Kolyhov/hls2915-servo-gimbal/docs/Render_Album_RU.pdf

# Три привода - три движения камеры

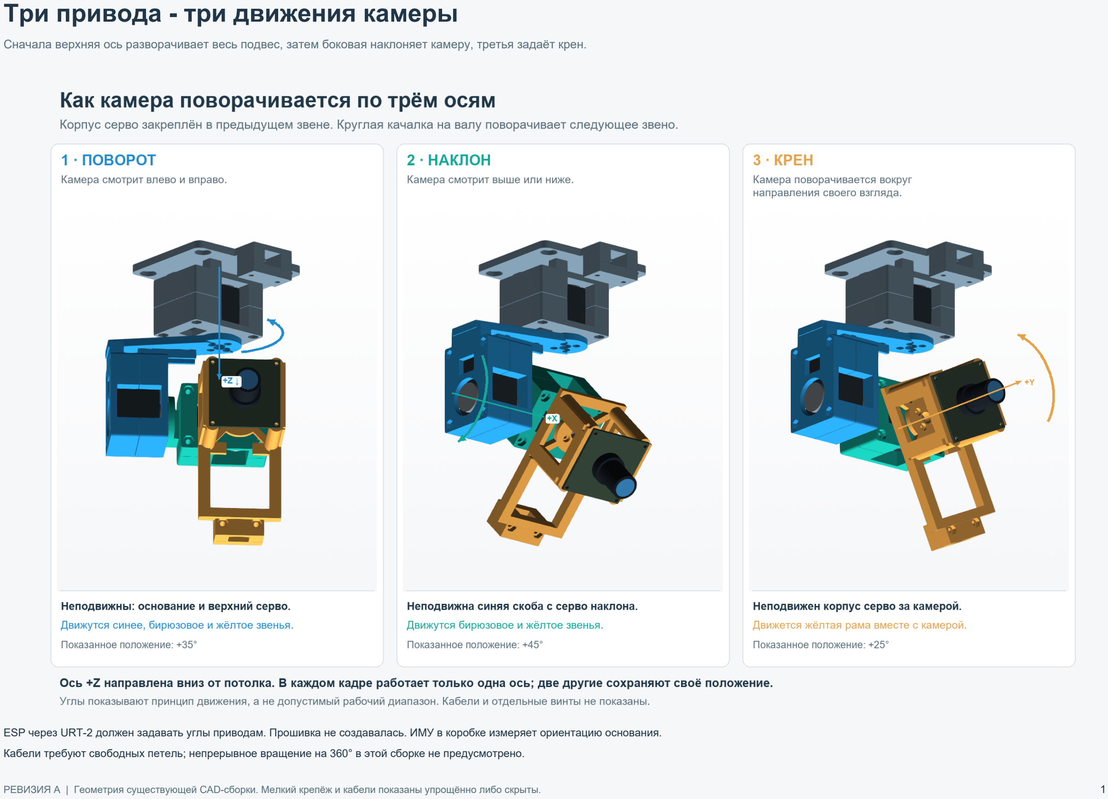
[picture p7: page 1]

Сначала верхняя ось разворачивает весь подвес, затем боковая наклоняет камеру, третья задаёт крен.

РЕВИЗИЯ A | Геометрия существующей CAD-сборки. Мелкий крепёж и кабели показаны упрощённо либо скрыты. | 1

ESP через URT-2 должен задавать углы приводам. Прошивка не создавалась. ИМУ в коробке измеряет ориентацию основания.

Кабели требуют свободных петель; непрерывное вращение на 360° в этой сборке не предусмотрено.

# Вся установка в сборе

Гимбал и коробка крепятся к потолку отдельно. Серый фрагмент - условный потолок.

РЕВИЗИЯ A | Геометрия существующей CAD-сборки. Мелкий крепёж и кабели показаны упрощённо либо скрыты. | 2
Спереди | Сзади
На уровне камеры | Снизу

# Гимбал: основные ракурсы

Синий кронштейн - поворот; зелёный - наклон; жёлтая рамка - крен.

РЕВИЗИЯ A | Геометрия существующей CAD-сборки. Мелкий крепёж и кабели показаны упрощённо либо скрыты. | 3
Спереди справа | Сзади слева
Спереди | Сзади

# Гимбал: боковые виды и наклон

Последний кадр: поворот 30°, наклон вниз 60°, крен 15°. Кабельные петли не показаны.

РЕВИЗИЯ A | Геометрия существующей CAD-сборки. Мелкий крепёж и кабели показаны упрощённо либо скрыты. | 4
Слева | Справа
Снизу | Камера повёрнута и наклонена

# Коробка в сборе: внешние виды

USB и выход шины | Противоположный угол

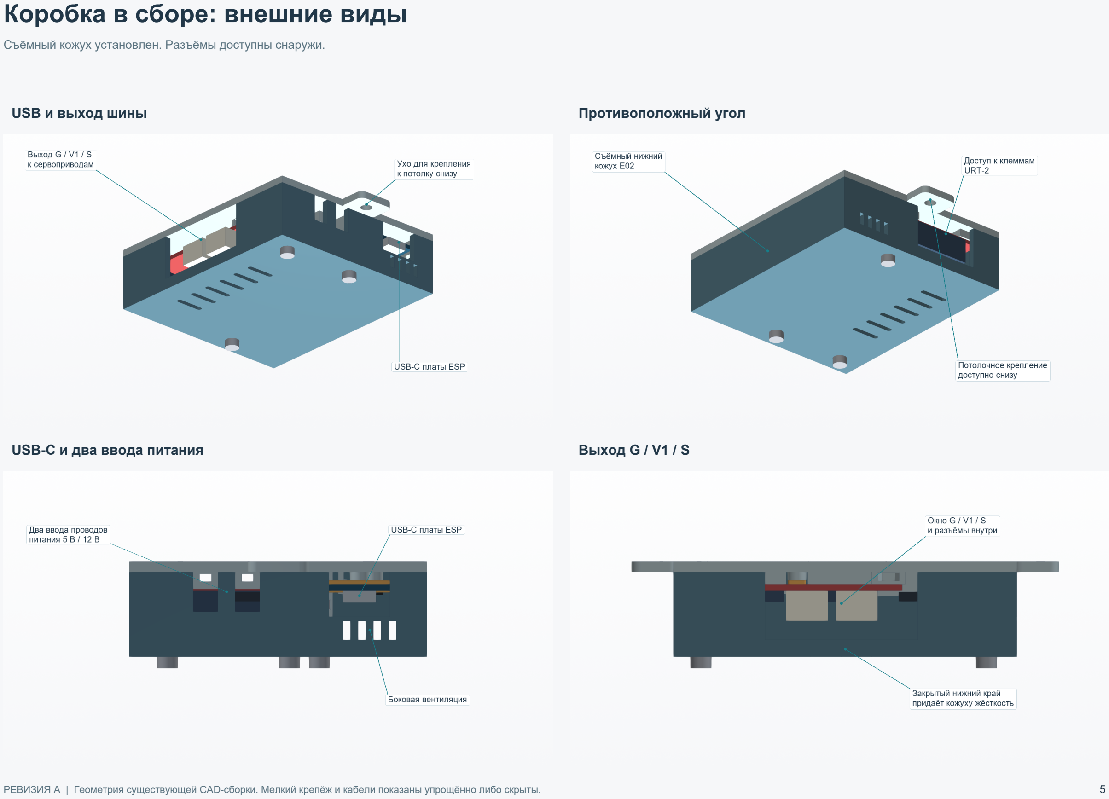
[picture p8: page 5]

Съёмный кожух установлен. Разъёмы доступны снаружи.

РЕВИЗИЯ A | Геометрия существующей CAD-сборки. Мелкий крепёж и кабели показаны упрощённо либо скрыты. | 5
USB-C и два ввода питания | Выход G / V1 / S

# Коробка: крепление, вентиляция и платы

Клеммы URT-2 | Вид снизу: вентиляция и винты

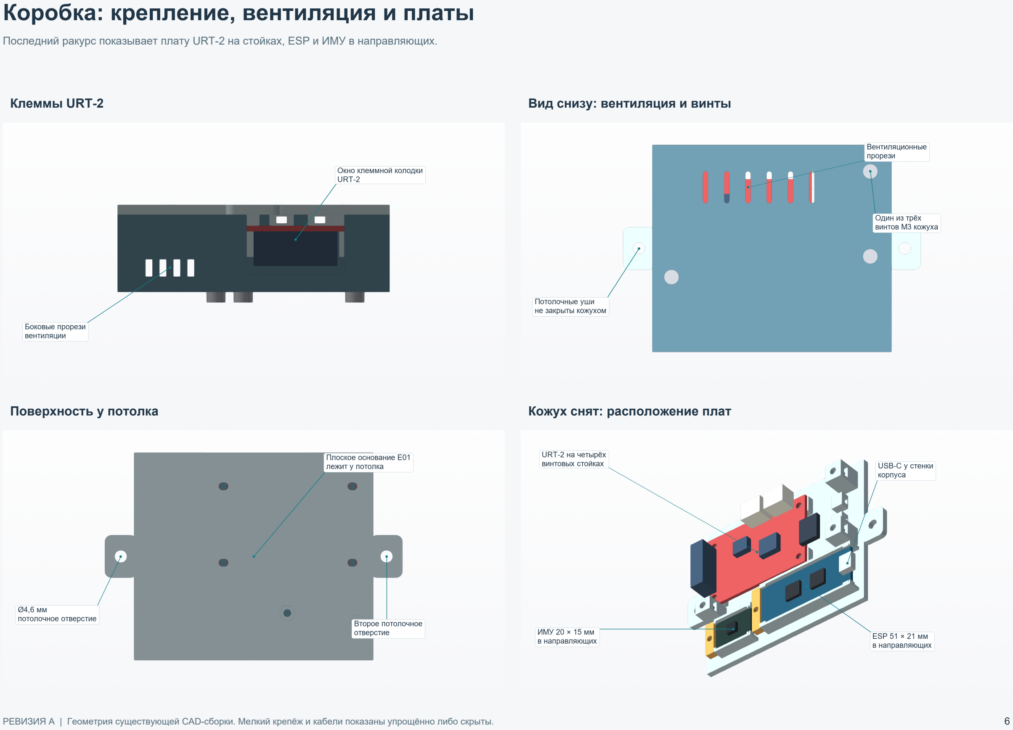
[picture p9: page 6]

Последний ракурс показывает плату URT-2 на стойках, ESP и ИМУ в направляющих.

РЕВИЗИЯ A | Геометрия существующей CAD-сборки. Мелкий крепёж и кабели показаны упрощённо либо скрыты. | 6
Поверхность у потолка | Кожух снят: расположение плат
