Kolyhov/hls2915-servo-gimbal/assets/motion-explained.gif

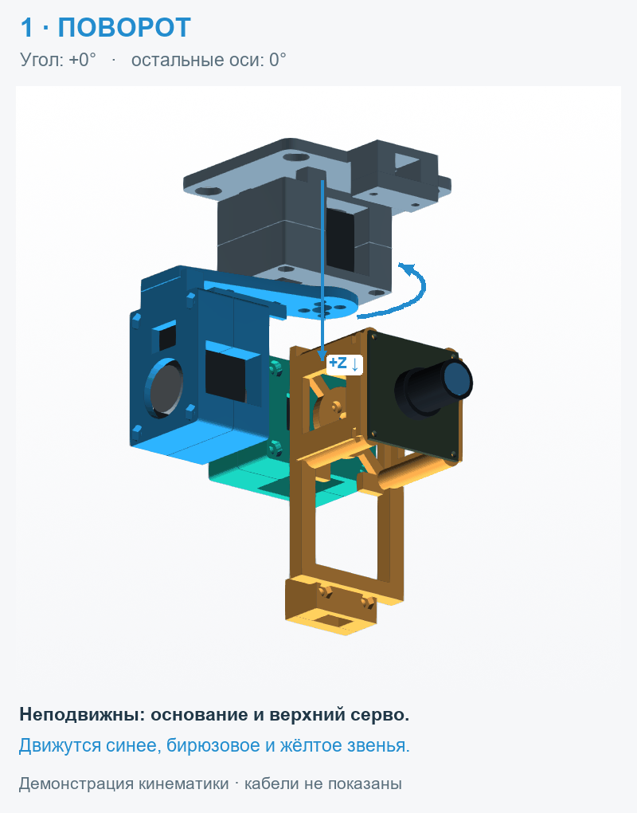
assets/motion-explained.gif
