Kolyhov/hls2915-servo-gimbal/assets/system-views.png

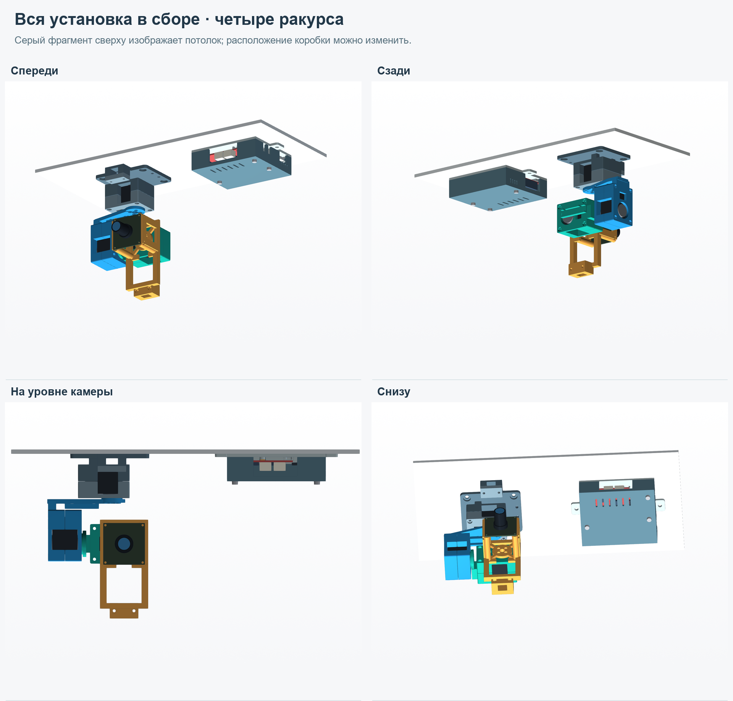
assets/system-views.png
