Kolyhov/hls2915-servo-gimbal/renders/enclosure/01_iso_usb_gvs.png

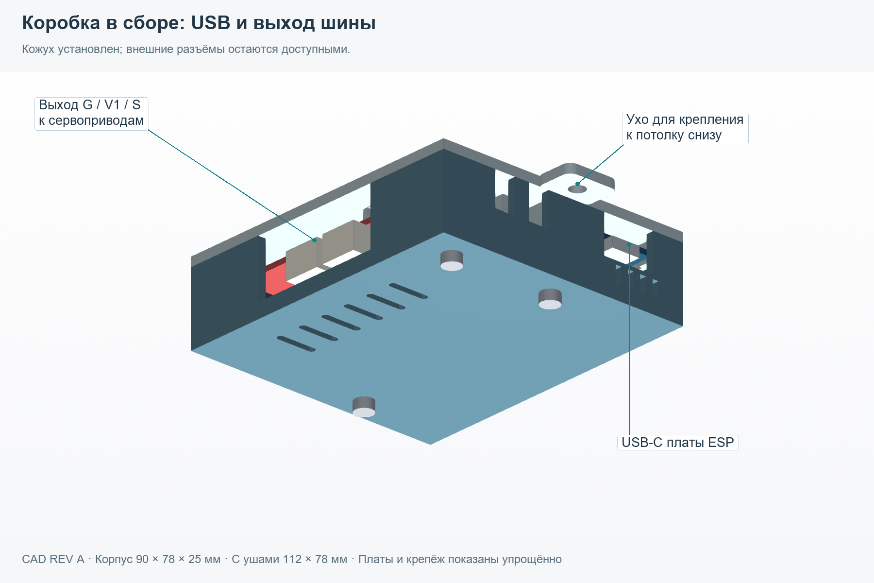
renders/enclosure/01_iso_usb_gvs.png
