Kolyhov/hls2915-servo-gimbal/renders/enclosure/02_iso_terminal_rear.png

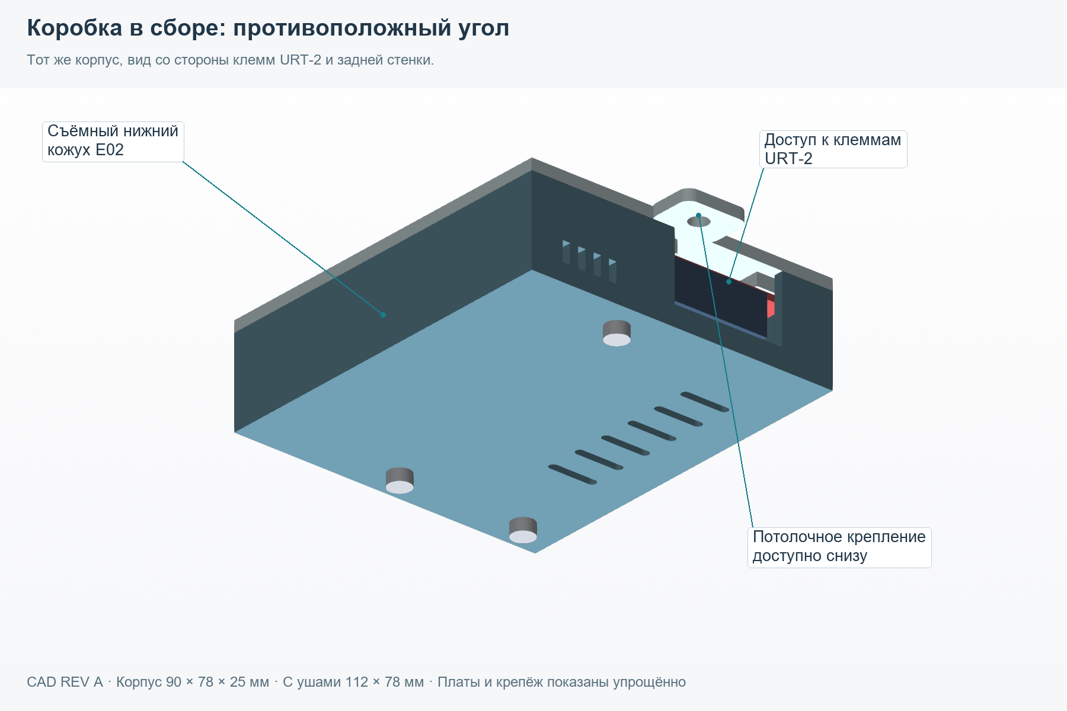
renders/enclosure/02_iso_terminal_rear.png
