Kolyhov/hls2915-servo-gimbal/renders/enclosure/03_usb_power_side.png

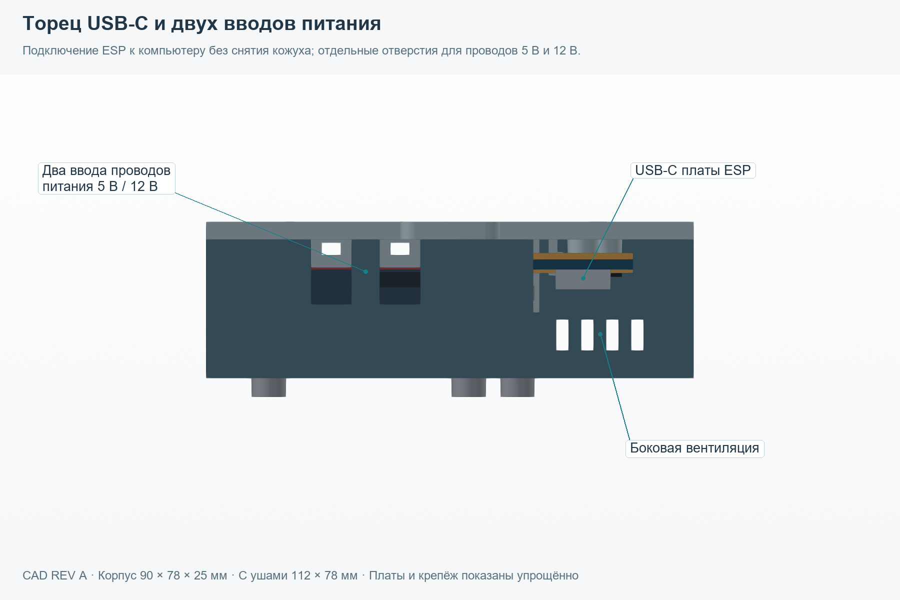
renders/enclosure/03_usb_power_side.png
