Kolyhov/hls2915-servo-gimbal/renders/enclosure/04_servo_bus_side.png

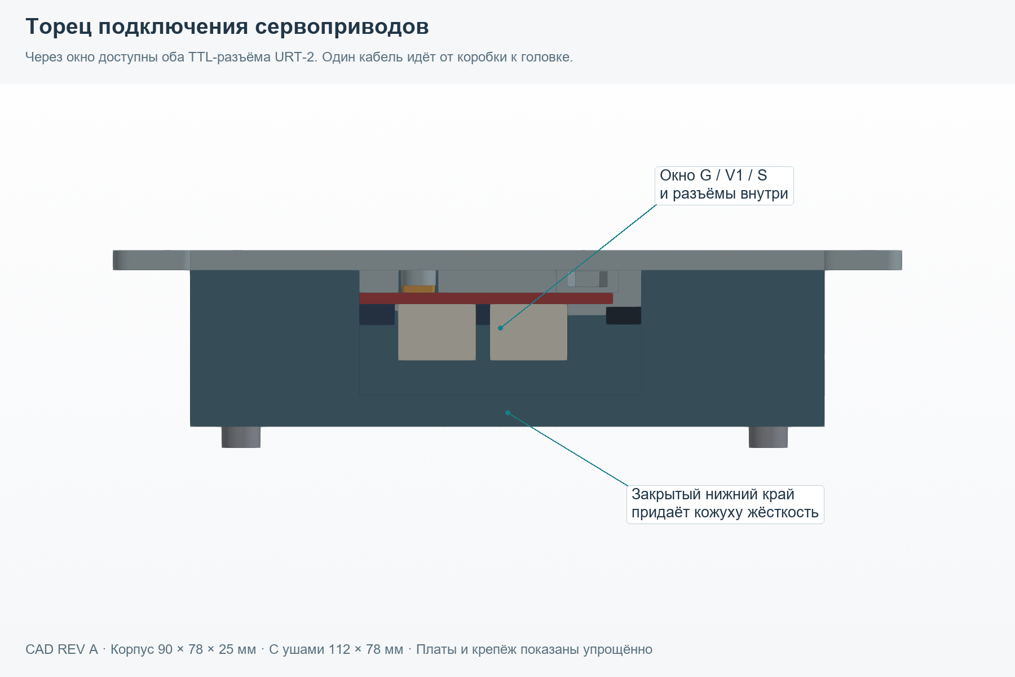
renders/enclosure/04_servo_bus_side.png
