Kolyhov/hls2915-servo-gimbal/renders/enclosure/05_terminal_power_side.png

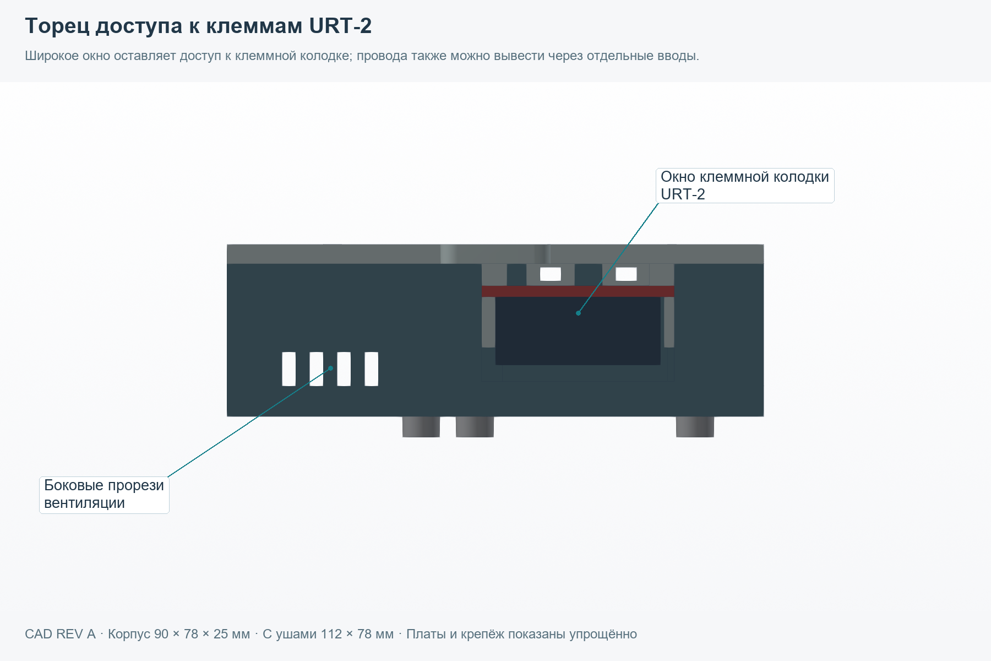
renders/enclosure/05_terminal_power_side.png
