Kolyhov/hls2915-servo-gimbal/renders/enclosure/06_underside_ventilation.png

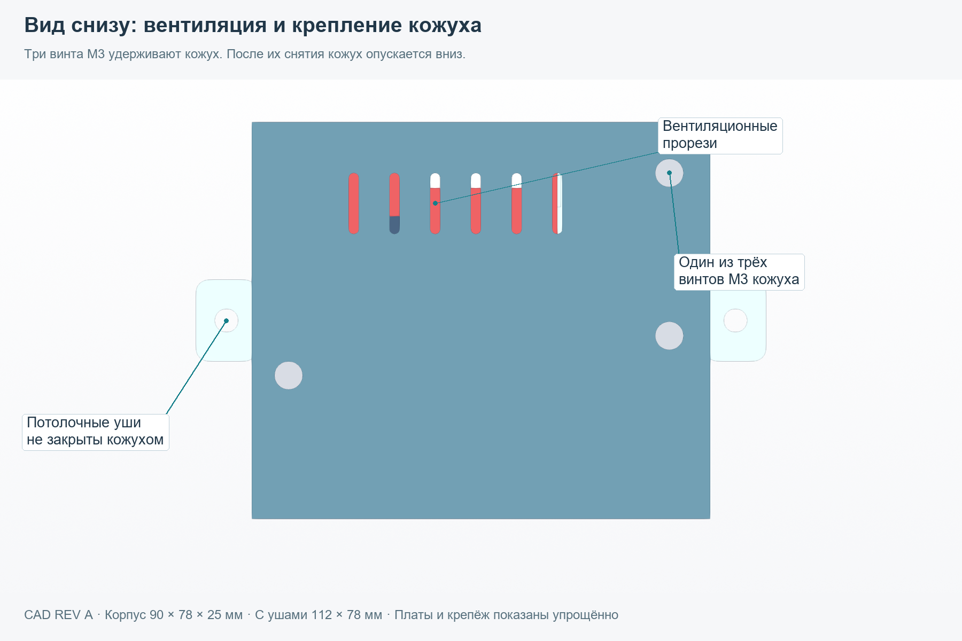
renders/enclosure/06_underside_ventilation.png
