Kolyhov/hls2915-servo-gimbal/renders/enclosure/07_ceiling_attachment_face.png

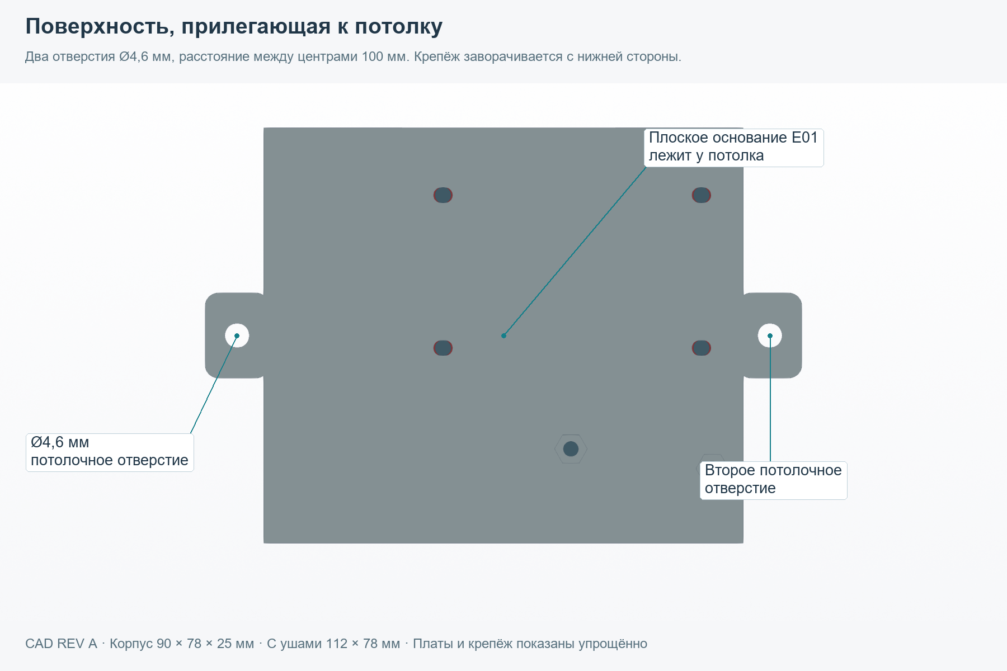
renders/enclosure/07_ceiling_attachment_face.png
