Kolyhov/hls2915-servo-gimbal/renders/enclosure/08_open_electronics_context.png

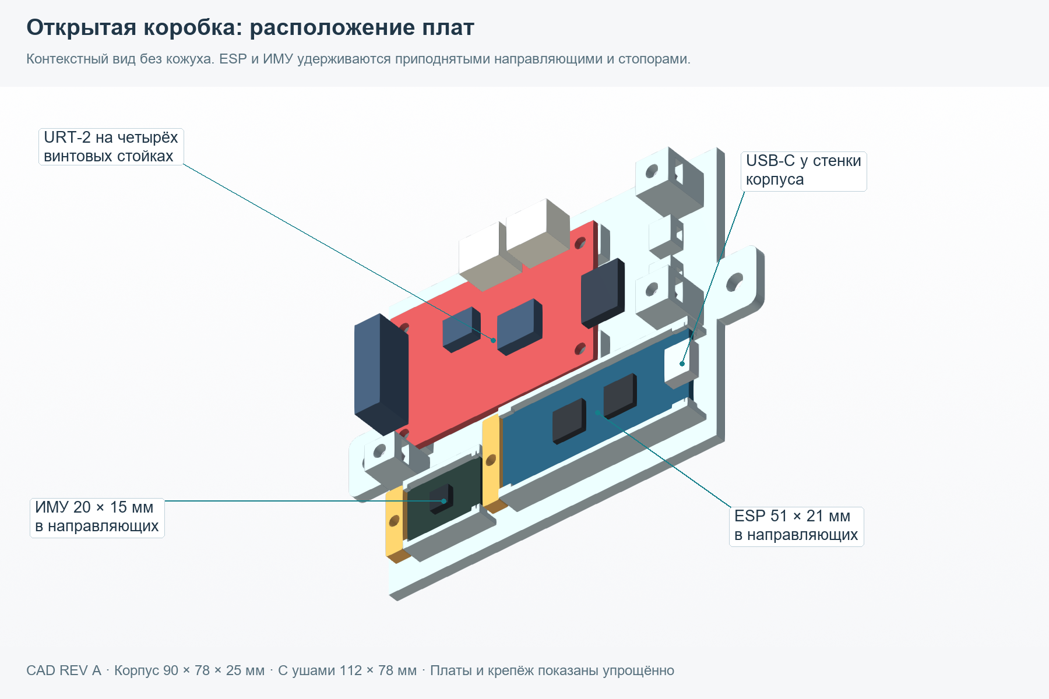
renders/enclosure/08_open_electronics_context.png
