Kolyhov/hls2915-servo-gimbal/renders/gimbal/01_front_3quarter.png

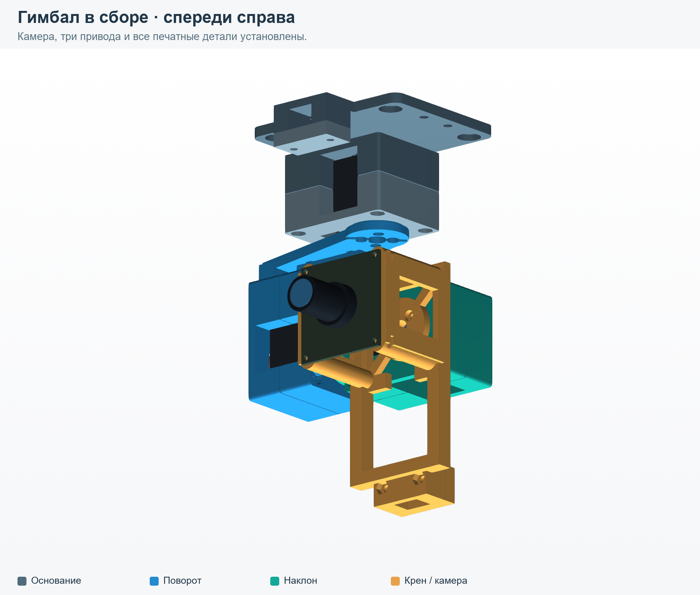
renders/gimbal/01_front_3quarter.png
