Kolyhov/hls2915-servo-gimbal/renders/gimbal/02_back_3quarter.png

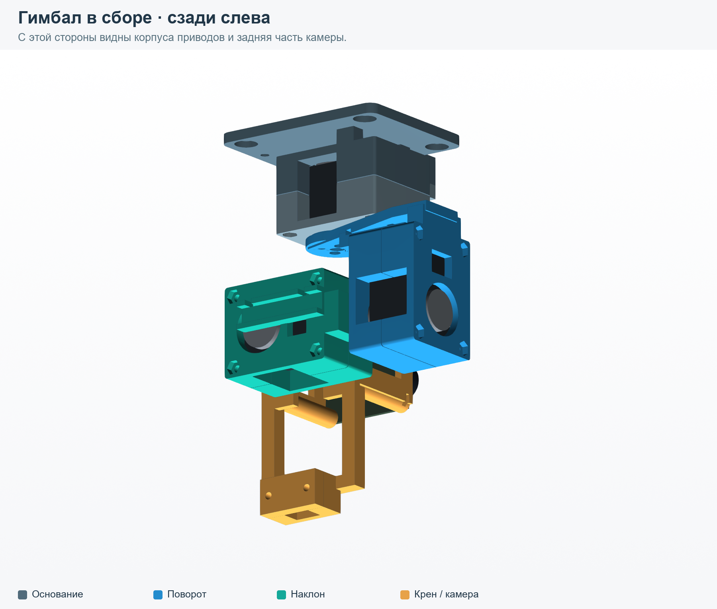
renders/gimbal/02_back_3quarter.png
