Kolyhov/hls2915-servo-gimbal/renders/gimbal/03_front.png

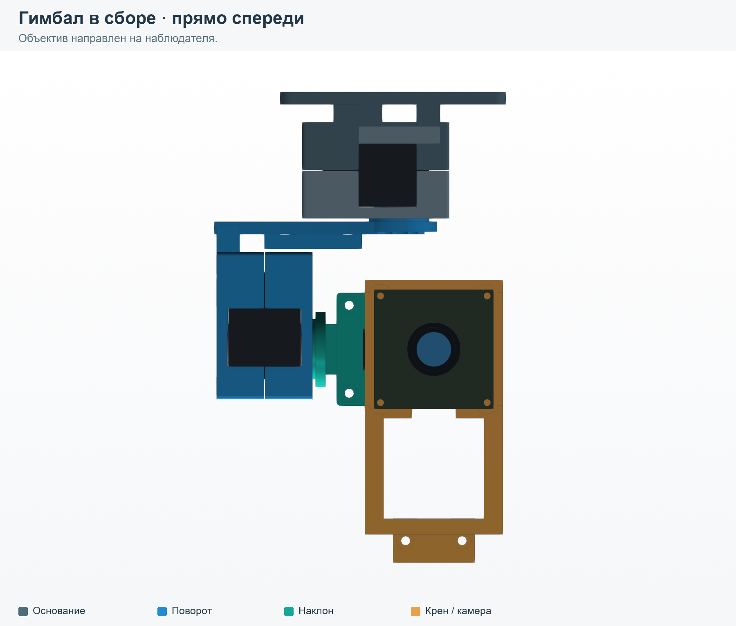
renders/gimbal/03_front.png
