Kolyhov/hls2915-servo-gimbal/renders/gimbal/04_back.png

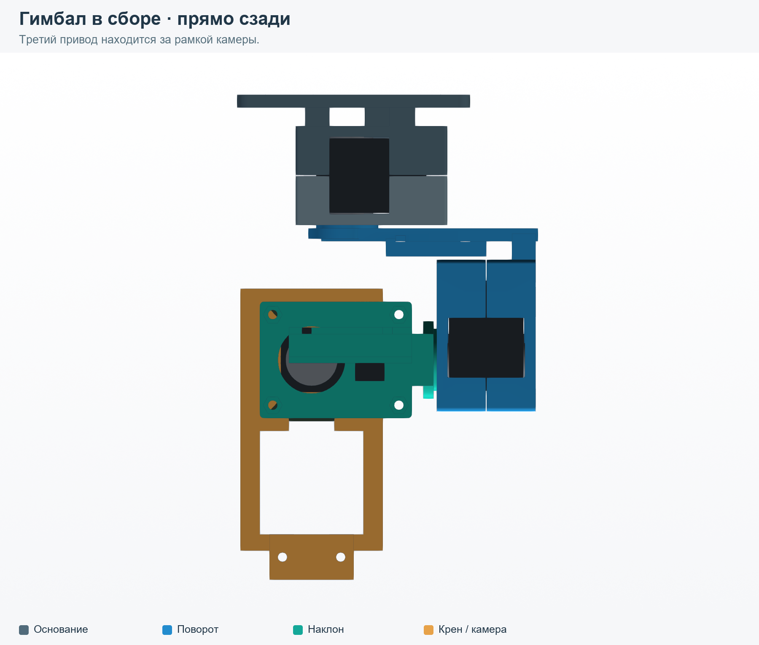
renders/gimbal/04_back.png
