Kolyhov/hls2915-servo-gimbal/renders/gimbal/05_left.png

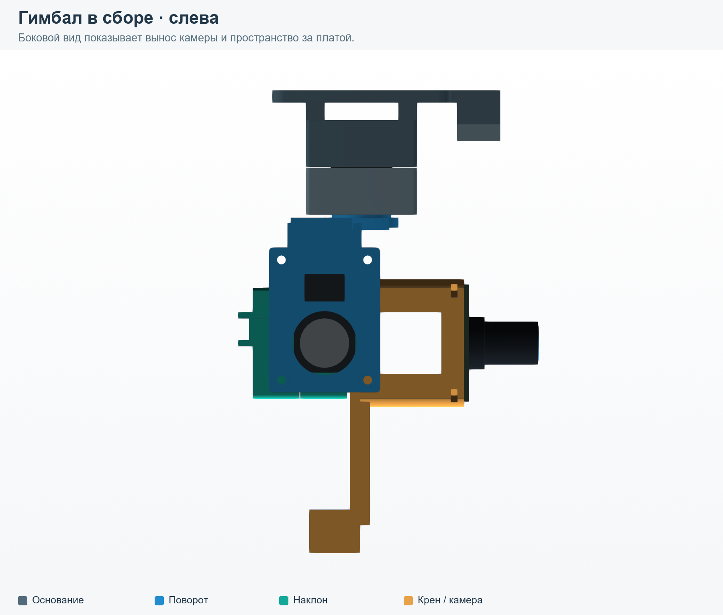
renders/gimbal/05_left.png
