Kolyhov/hls2915-servo-gimbal/renders/gimbal/06_right.png

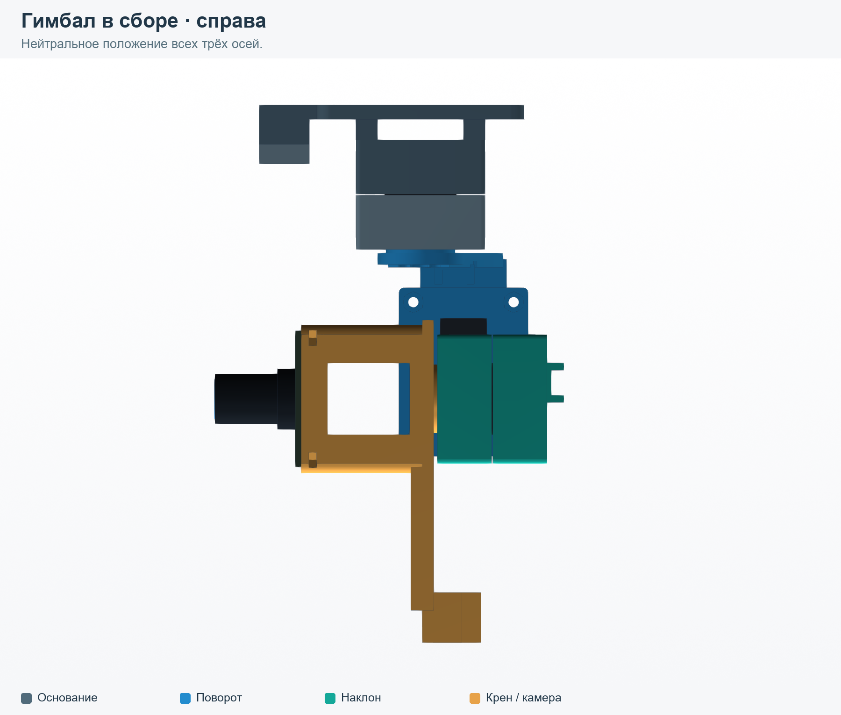
renders/gimbal/06_right.png
