Kolyhov/hls2915-servo-gimbal/renders/gimbal/07_below.png

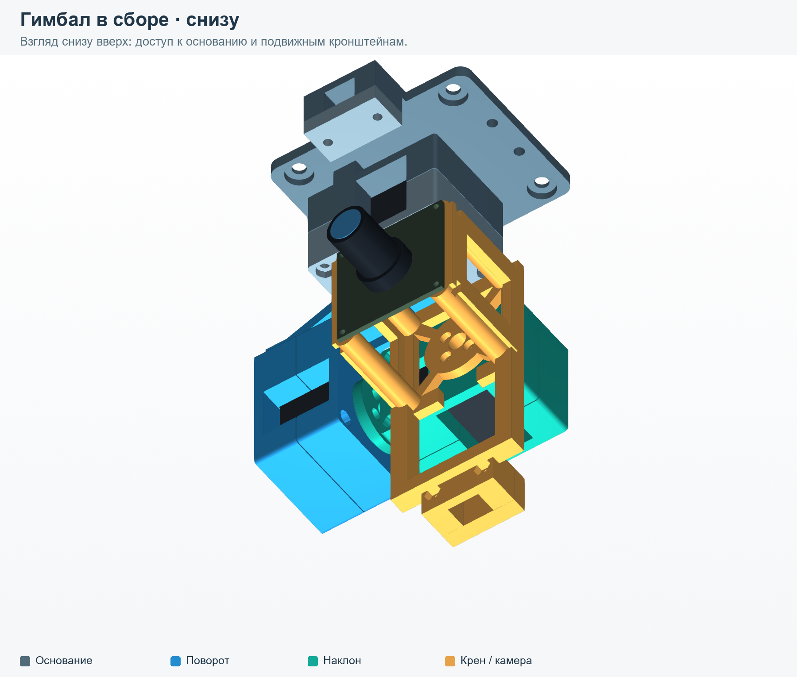
renders/gimbal/07_below.png
