Kolyhov/hls2915-servo-gimbal/renders/gimbal/08_tilted.png

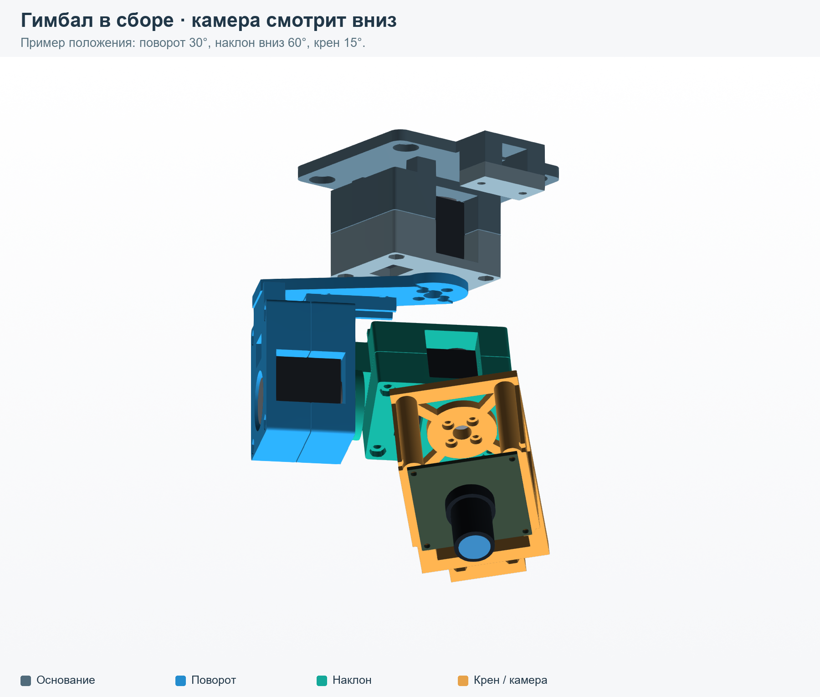
renders/gimbal/08_tilted.png
