Kolyhov/hls2915-servo-gimbal/renders/system/02_rear.png

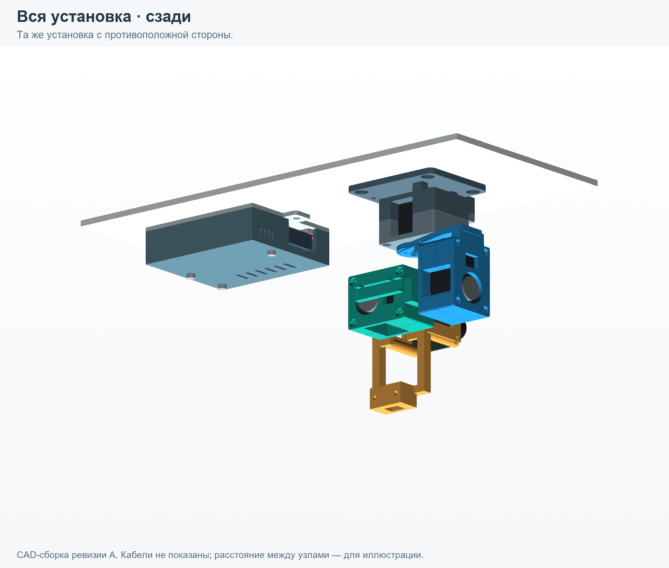
renders/system/02_rear.png
