Kolyhov/hls2915-servo-gimbal/renders/system/03_front_level.png

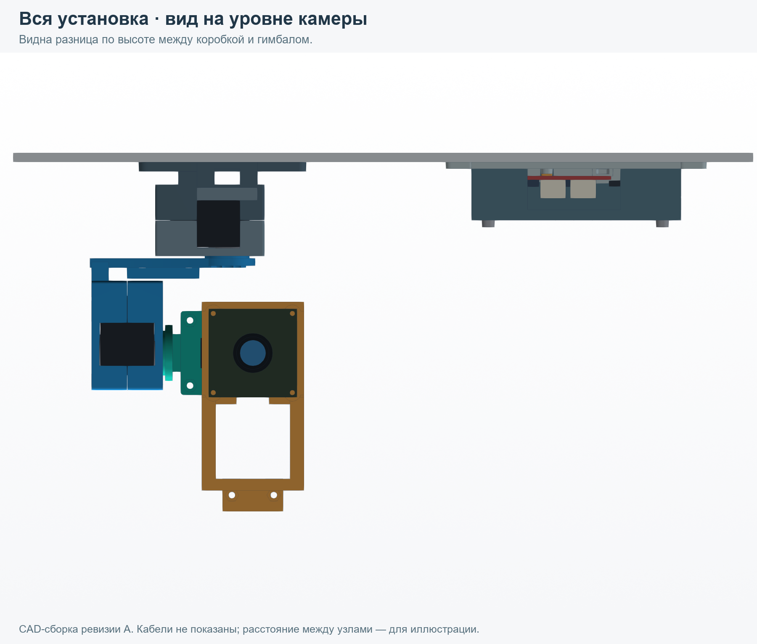
renders/system/03_front_level.png
