Kolyhov/hls2915-servo-gimbal/renders/system/04_from_below.png

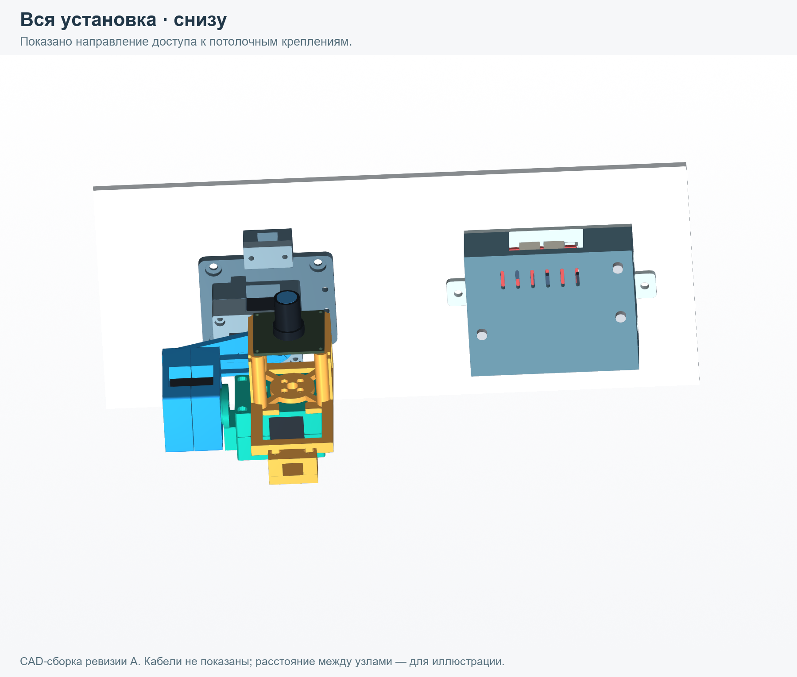
renders/system/04_from_below.png
