Kolyhov/hls2915-servo-gimbal/renders/assembly/07_print_parts.png

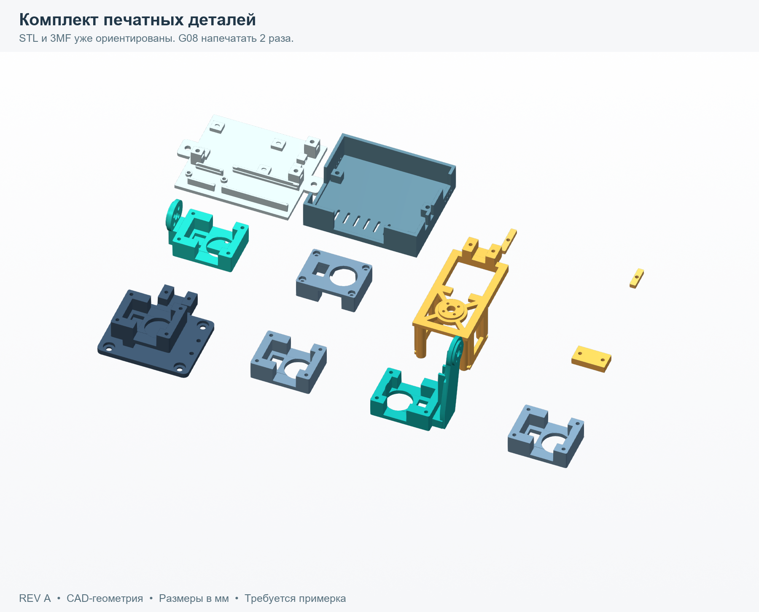
renders/assembly/07_print_parts.png
