Kolyhov/hls2915-servo-gimbal/cad/step/Gimbal_assembly_reference.step

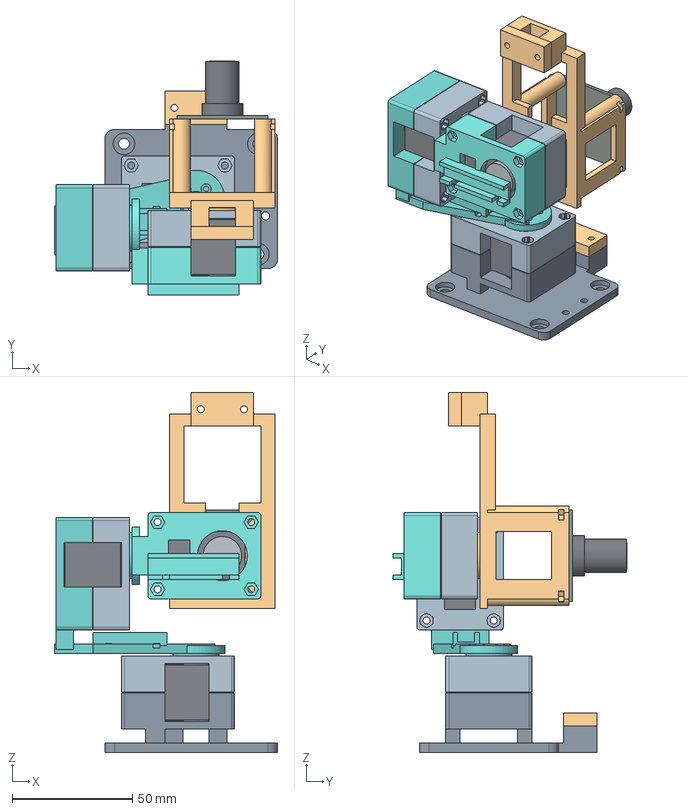
[picture p32: CAD file, 2026-10-14]
cad/step/Gimbal_assembly_reference.step
93.0 x 97.5 x 150.0 mm
item_00
item_01
item_02
item_03
item_04
item_05
item_06
item_07
item_08
item_09
item_10
item_11
item_12
item_13
item_14
item_15
item_16
item_17
