Kolyhov/hls2915-servo-gimbal/cad/step/G02_Yaw_clamp.step

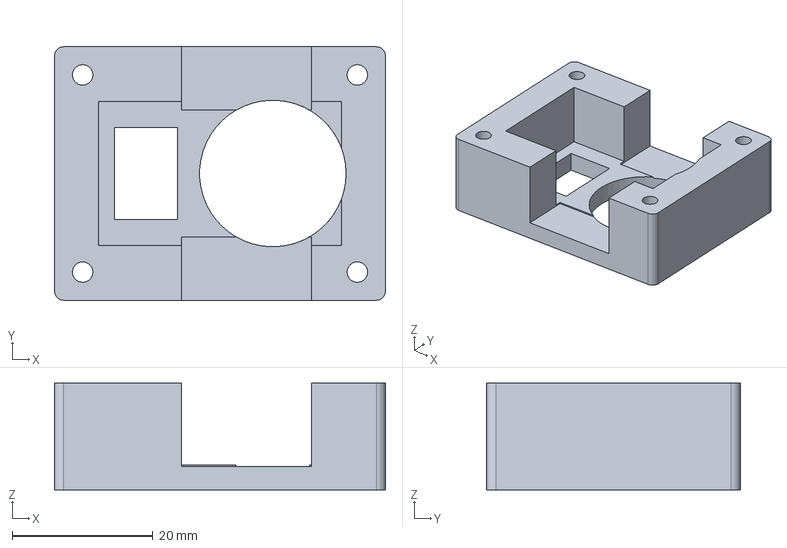
[picture p34: CAD file, 2026-10-14]
cad/step/G02_Yaw_clamp.step
47.0 x 36.0 x 15.1 mm
