Kolyhov/hls2915-servo-gimbal/print/fit-coupons/Fit_Coupons.3mf

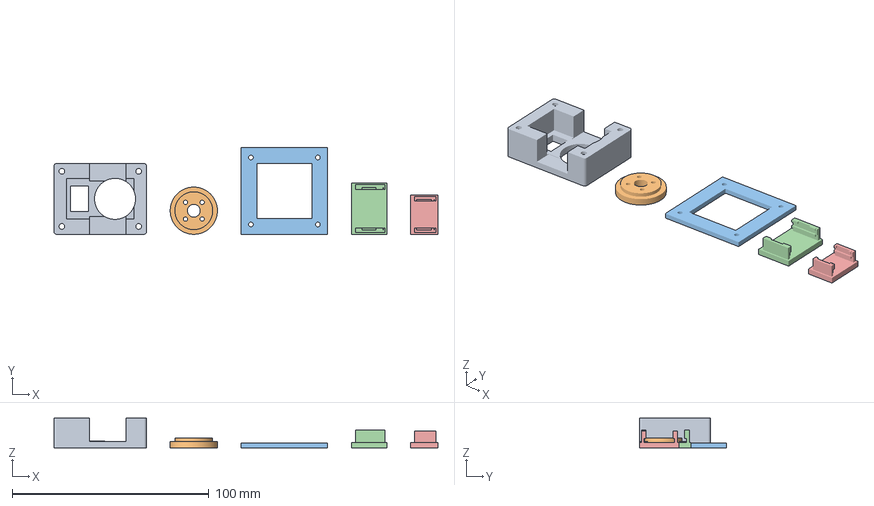
[picture p35: CAD file, 2026-10-14]
print/fit-coupons/Fit_Coupons.3mf
195.0 x 44.0 x 15.2 mm
T01 Servo_half_fit
T02 Horn_interface_fit
T03 Camera_hole_fit
C01_ESP_rail C01_ESP_rail
C02_IMU_rail C02_IMU_rail
