Kolyhov/hls2915-servo-gimbal/print/Gimbal_Enclosure_AllParts_H2S.stl

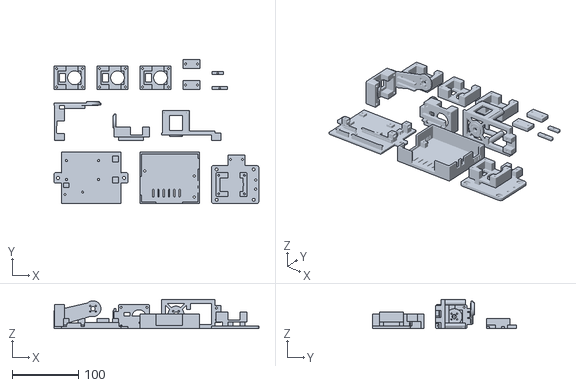
[picture p36: CAD file, 2026-10-14]
print/Gimbal_Enclosure_AllParts_H2S.stl
310.0 x 218.5 x 44.0
