Kolyhov/hls2915-servo-gimbal/print/parts/G05.stl

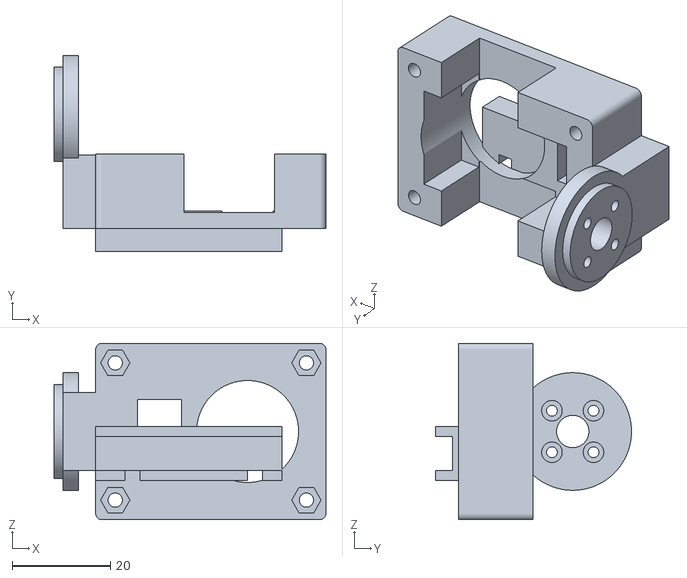
[picture p37: CAD file, 2026-10-14]
print/parts/G05.stl
55.5 x 40.0 x 36.0
