Kolyhov/hls2915-servo-gimbal/print/fit-coupons/T02_Horn_interface_fit.stl

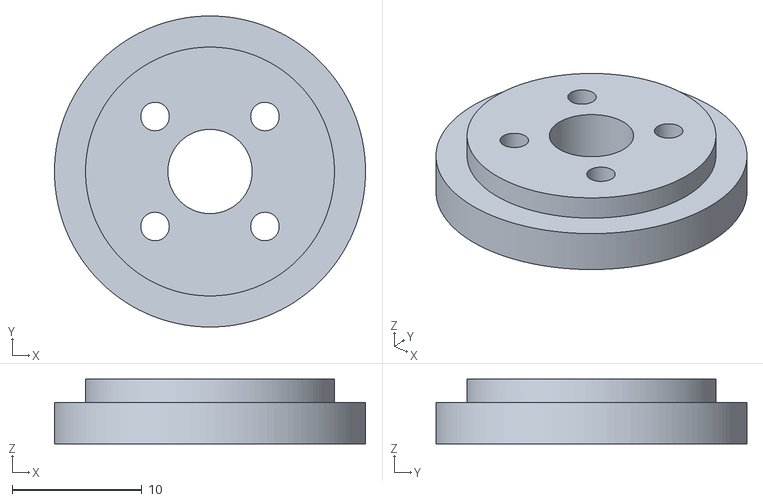
[picture p38: CAD file, 2026-10-14]
print/fit-coupons/T02_Horn_interface_fit.stl
24.0 x 24.0 x 5.00
