Kolyhov/hls2915-servo-gimbal/print/parts/G03.stl

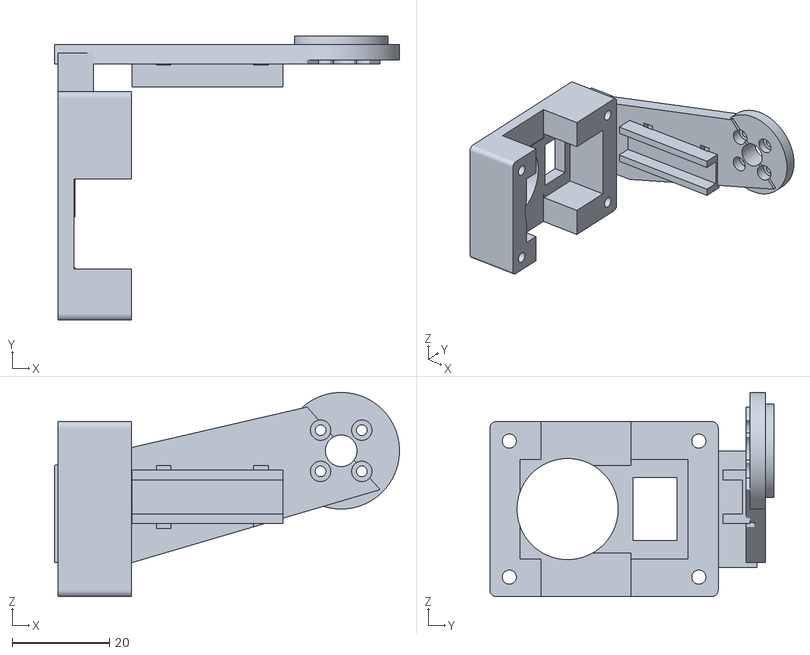
[picture p39: CAD file, 2026-10-14]
print/parts/G03.stl
71.0 x 58.5 x 42.0
