Kolyhov/hls2915-servo-gimbal/cad/step/E03_ESP_retainer.step

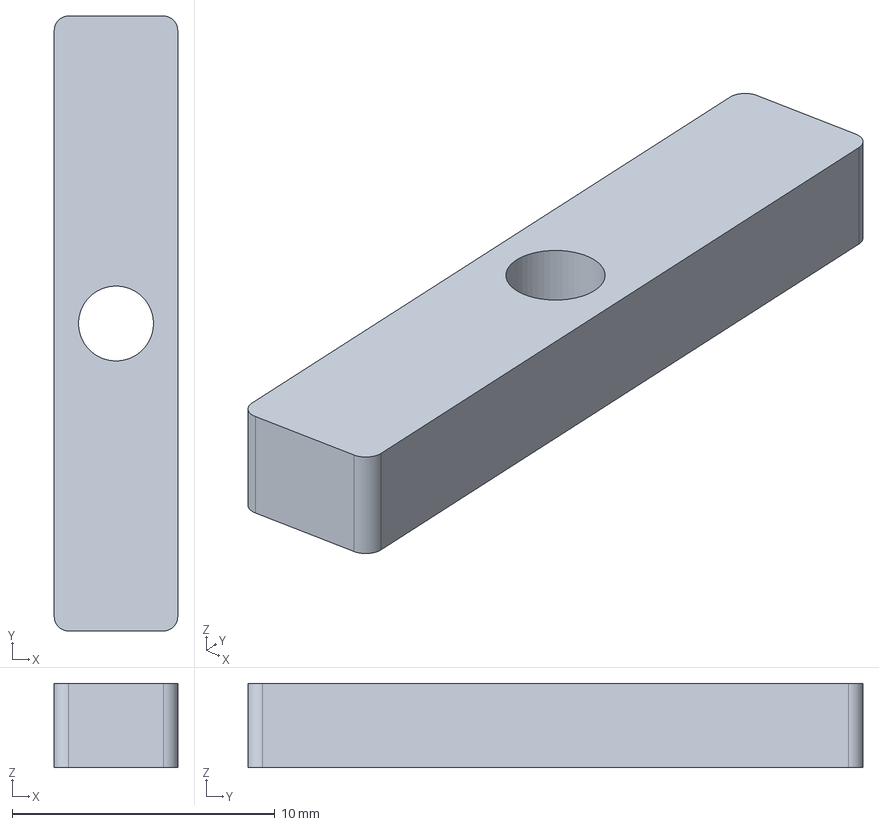
[picture p40: CAD file, 2026-10-14]
cad/step/E03_ESP_retainer.step
4.70 x 23.4 x 3.20 mm
