Kolyhov/hls2915-servo-gimbal/print/fit-coupons/C02_IMU_rail.stl

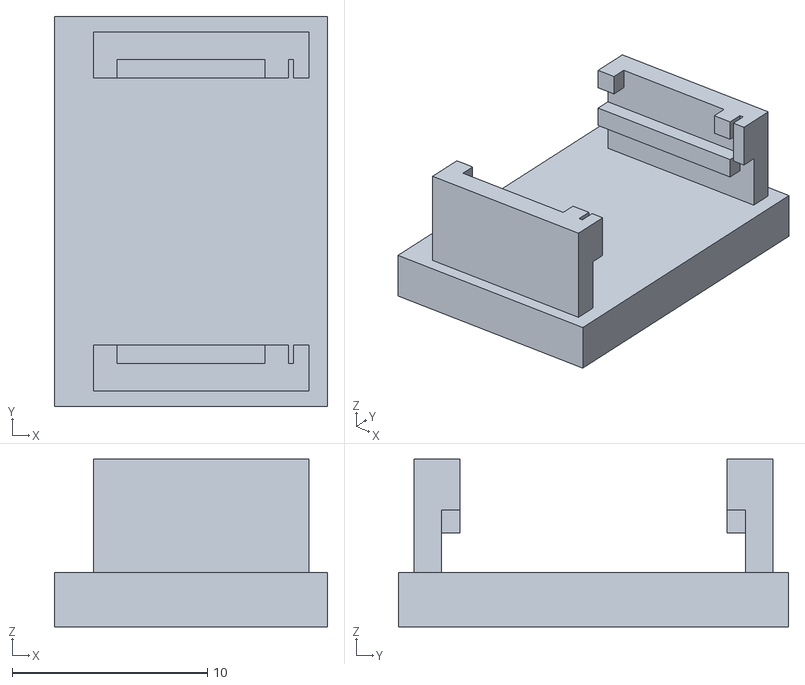
[picture p41: CAD file, 2026-10-14]
print/fit-coupons/C02_IMU_rail.stl
14.0 x 20.0 x 8.60
