Kolyhov/hls2915-servo-gimbal/print/parts/G07.stl

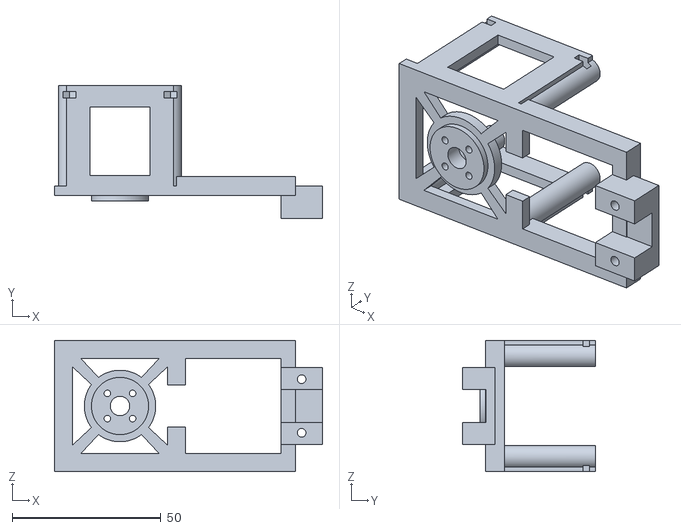
[picture p42: CAD file, 2026-10-14]
print/parts/G07.stl
90.0 x 44.8 x 44.0
