Kolyhov/hls2915-servo-gimbal/cad/step/C01_ESP_rail.step

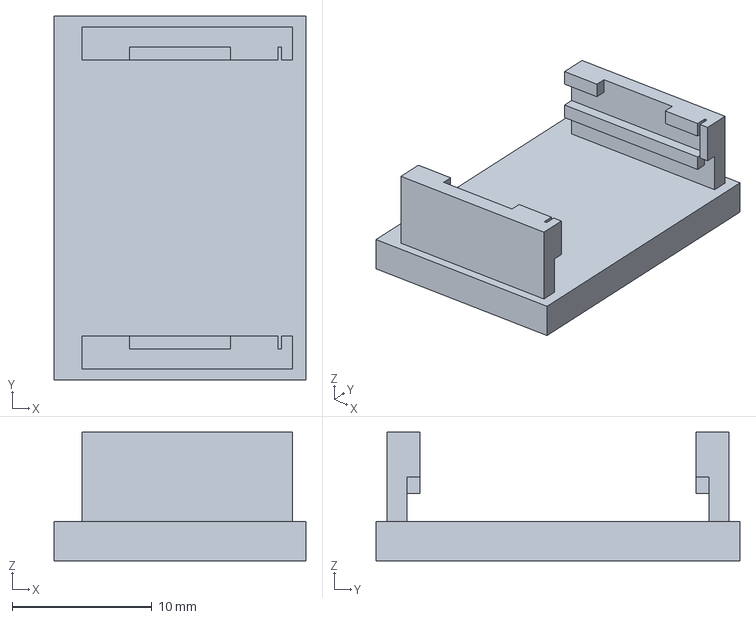
[picture p43: CAD file, 2026-10-14]
cad/step/C01_ESP_rail.step
18.0 x 26.0 x 9.20 mm
