Kolyhov/hls2915-servo-gimbal/print/parts/G01.stl

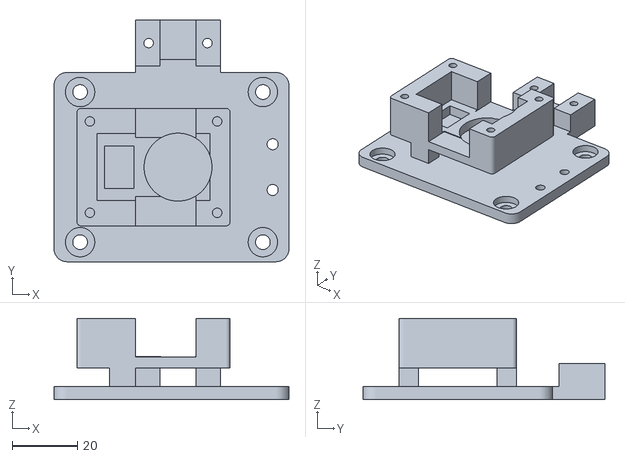
[picture p44: CAD file, 2026-10-14]
print/parts/G01.stl
72.0 x 74.0 x 24.9
