Kolyhov/hls2915-servo-gimbal/cad/step/G08_USB_cap.step

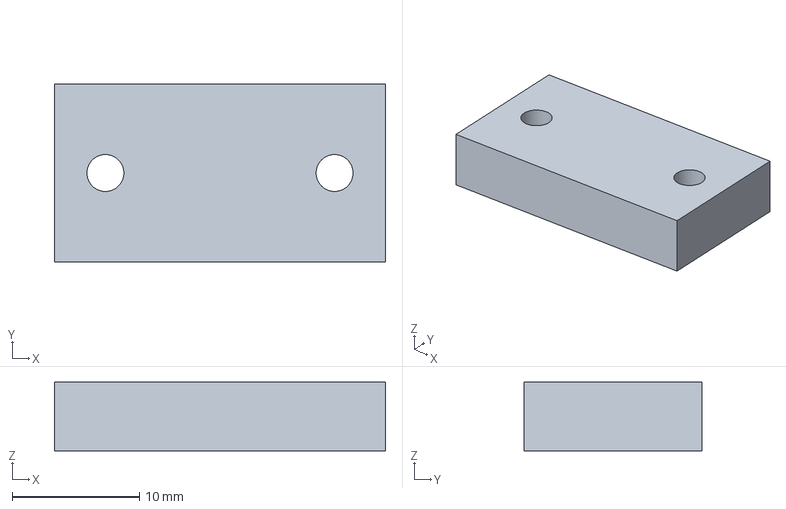
[picture p45: CAD file, 2026-10-14]
cad/step/G08_USB_cap.step
26.0 x 14.0 x 5.40 mm
