Kolyhov/hls2915-servo-gimbal/print/fit-coupons/T03_Camera_hole_fit.stl

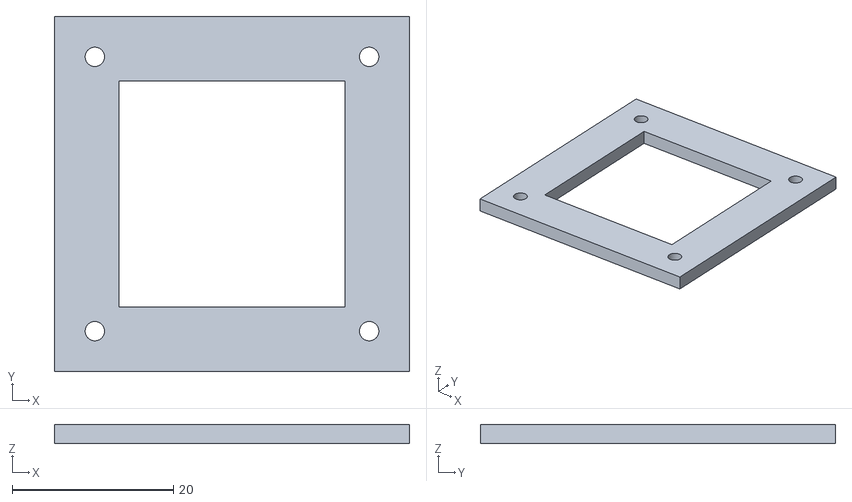
[picture p46: CAD file, 2026-10-14]
print/fit-coupons/T03_Camera_hole_fit.stl
44.0 x 44.0 x 2.40
