Kolyhov/hls2915-servo-gimbal/cad/step/E04_IMU_retainer.step

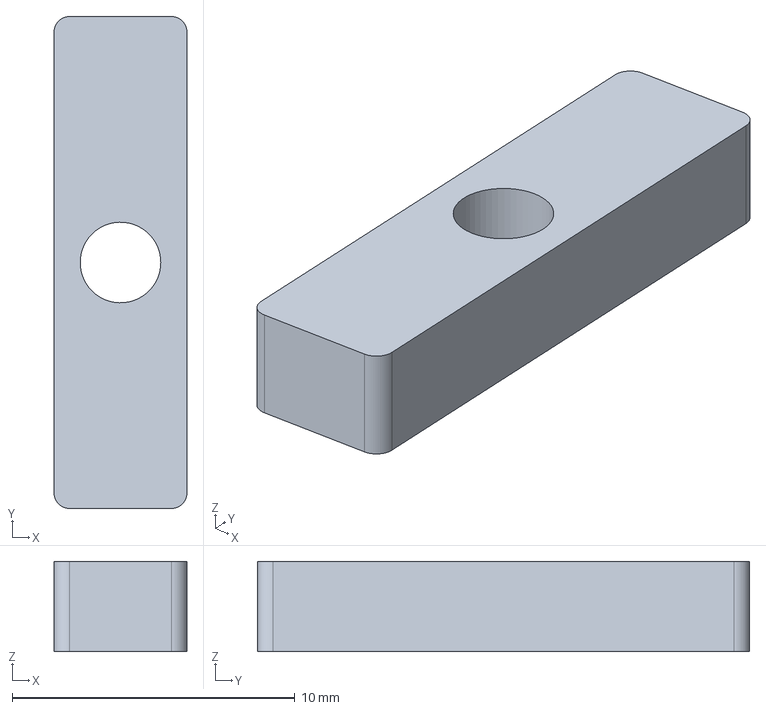
[picture p47: CAD file, 2026-10-14]
cad/step/E04_IMU_retainer.step
4.70 x 17.4 x 3.20 mm
