Kolyhov/hls2915-servo-gimbal/cad/step/E01_ceiling_base.step

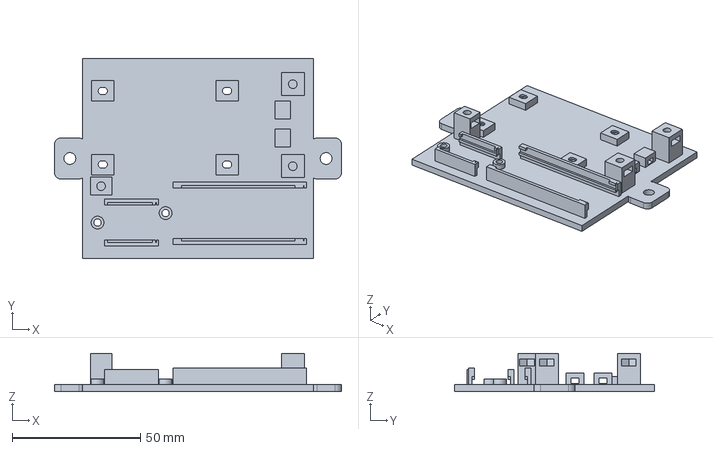
[picture p48: CAD file, 2026-10-14]
cad/step/E01_ceiling_base.step
112.0 x 78.0 x 15.0 mm
