Kolyhov/hls2915-servo-gimbal/cad/step/E02_removable_cover.step

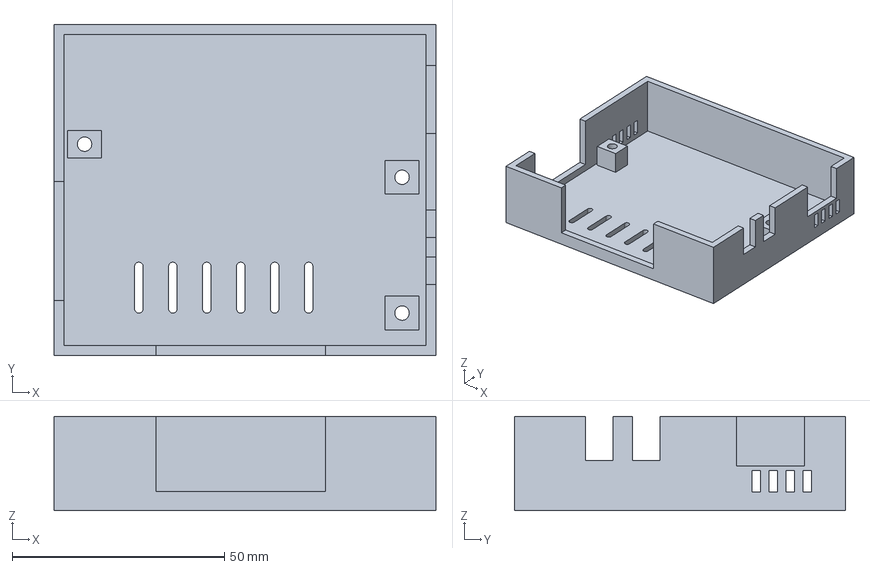
[picture p49: CAD file, 2026-10-14]
cad/step/E02_removable_cover.step
90.0 x 78.0 x 22.2 mm
