Kolyhov/hls2915-servo-gimbal/(list of files, cad)

Other CAD files:
cad/step/G05_Pitch_carrier.step
print/AllParts_H2S.3mf
print/fit-coupons/T01_Servo_half_fit.stl
print/fit-coupons/C01_ESP_rail.stl
print/parts/G04.stl
cad/step/T02_Horn_interface_fit.step
print/parts/G06.stl
cad/step/G07_Camera_frame.step
print/parts/G02.stl
cad/step/T03_Camera_hole_fit.step
print/parts/G08.stl
cad/step/C02_IMU_rail.step
cad/step/G03_Yaw_carrier.step
cad/step/G04_Pitch_clamp.step
cad/step/T01_Servo_half_fit.step
cad/step/G01_Ceiling_mount.step
cad/step/G06_Roll_clamp.step
print/parts/E01_ceiling_base.stl
print/parts/E02_removable_cover.stl
print/parts/E03_ESP_retainer.stl
print/parts/E04_IMU_retainer.stl
