Kolyhov/hls2915-servo-gimbal/docs/PRINT_RU.txt

ОДИН STL: ГИМБАЛ + КОРОБКА / H2S / РЕВИЗИЯ A

Файл Gimbal_Enclosure_AllParts_H2S.stl содержит 13 раздельных деталей
в нужном количестве: G01-G07 по одной, G08 две, E01-E04 по одной.
Пробники, платы, сервоприводы, винты и изображённый на рендере стол
в STL не входят. Детали лежат отдельно, не соединены перемычками.

Все нижние опорные грани находятся на Z=0. Раскладка центрирована
на столе 340 x 320 мм. Зазоры между габаритами деталей минимум 18 мм.
Размер всей раскладки: 310.0 x 218.5 x 44.0 мм. Единицы — миллиметры.

ОТКРЫТИЕ В BAMBU STUDIO
1. Выбрать H2S, сопло 0,4 мм, профиль своего PETG.
2. Открыть STL, масштаб 100%. Сохранить исходную раскладку.
   Автоповорот и автоматическая раскладка не нужны.
3. Включить автоматические поддержки. Для G01, G03, G05 и G07
   поддержки обязательны. Не ограничивать их только столом, если
   при просмотре слоёв остаются неподдержанные участки.
4. Для устойчивости использовать внешнюю кайму около 6 мм.
5. Печатать ПО СЛОЯМ, не последовательно по объектам.
6. Нарезать и просмотреть поддержки, каналы и гнёзда гаек.

Начальные параметры: слой 0,20 мм, 5 стенок, 6 верхних/нижних слоёв,
35% gyroid; температуры и скорость — по откалиброванному профилю PETG.
Точные зазоры и интерфейс поддержек зависят от материала и калибровки.

Проверено: 13 замкнутых связных сеток, правильные нормали,
каждая деталь касается стола, габариты не пересекаются, стол H2S
вмещает раскладку с запасом. Печатные детали геометрически не изменены;
улучшена ориентация G03, G05, G06, G07 по сравнению с прежней раскладкой.
STL не содержит настройки материала, поддержек или G-code.
Физическая печать и нарезка этого файла не выполнялись.
