Kolyhov/hls2915-servo-gimbal/renders/assembly/02_gimbal_rear.png

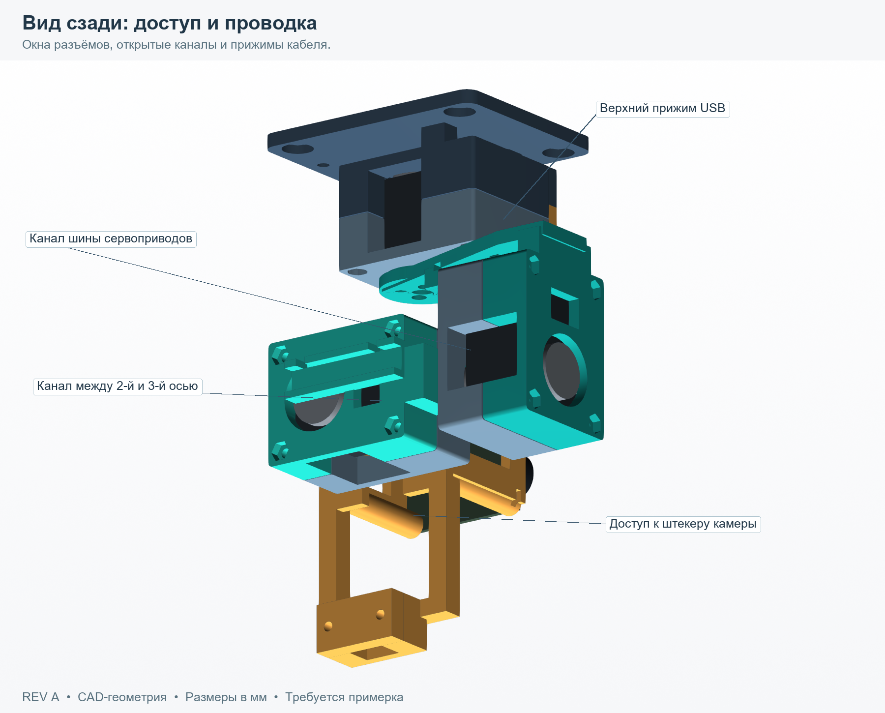
renders/assembly/02_gimbal_rear.png
