Kolyhov/hls2915-servo-gimbal/renders/assembly/05_box_exploded.png

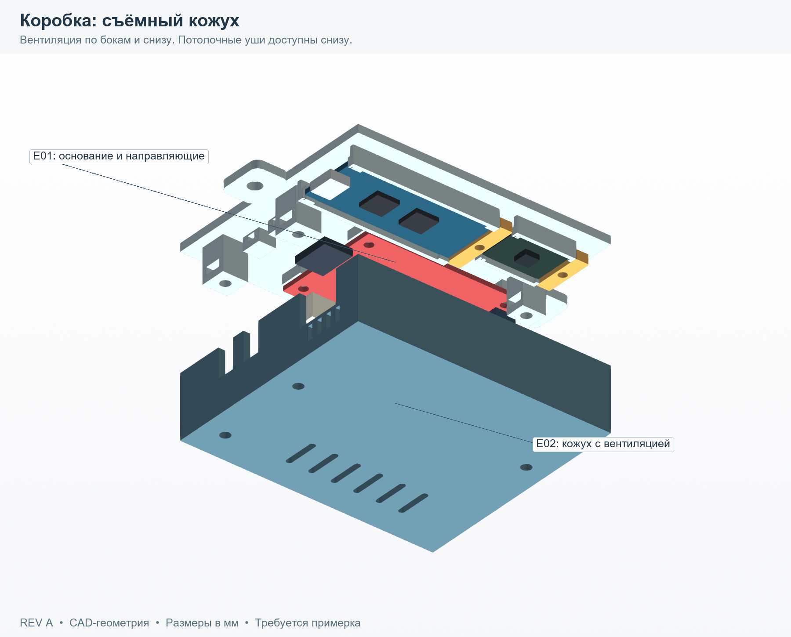
renders/assembly/05_box_exploded.png
