Kolyhov/hls2915-servo-gimbal/renders/assembly/06_box_closed.png

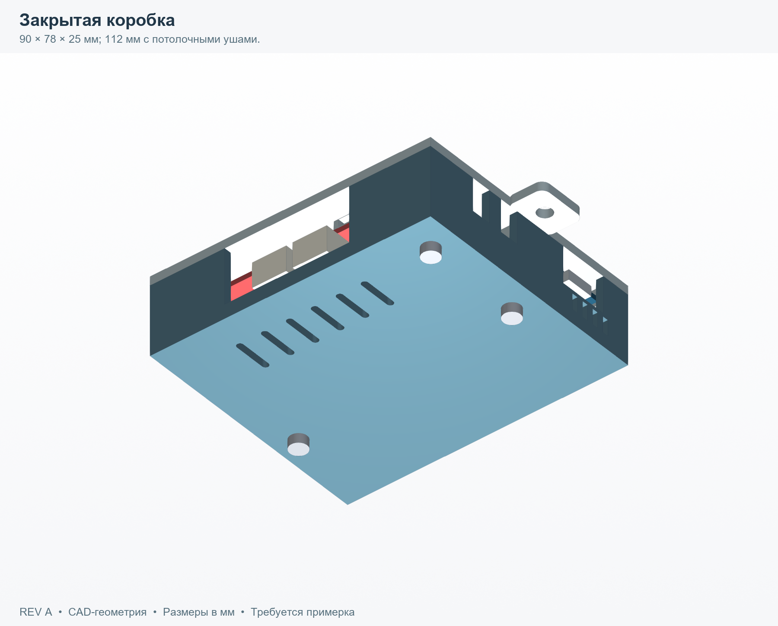
renders/assembly/06_box_closed.png
