Kolyhov/hls2915-servo-gimbal/renders/assembly/08_front_orthographic.png

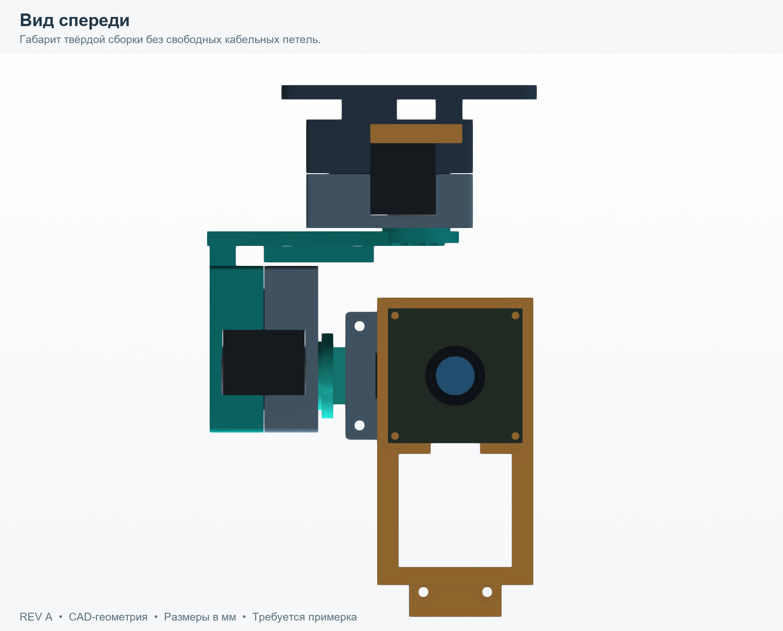
renders/assembly/08_front_orthographic.png
