Kolyhov/hls2915-servo-gimbal/CHANGELOG.md

# Изменения

## Rev A — 2026-10-14

- Трёхосевой потолочный подвес для трёх HLS-2915M и камеры DECXIN-2M-2159V1.
- Отдельная вентилируемая коробка с направляющими ESP/ИМУ и винтовыми стойками URT-2.
- Каналы для сервошины и прижимы жёсткого USB-кабеля камеры.
- Единый STL на 13 деталей с уточнённой ориентацией G03, G05, G06 и G07; идентичная геометрическая раскладка 3MF.
- Отдельные STL, пробники, STEP и исходники CadQuery.
- Инструкция на русском, альбом ракурсов и анимированная CAD-обложка.

Статус: геометрически проверенный прототип; физическая сборка и испытания ещё не выполнены.
